AshMudaly/Capstone_HES_Project/5_Reported_data/thrust_and_hybrid_runs_filled.xlsx

Sheet: Setup
Setup: shared constants and run log
Yellow cells with blue text are typed in. Everything else calculates. Battery-only runs B1-B5 are RUN67-RUN71 (1200-1700 us profile). Hybrid runs H1-H5 are RUN75-RUN79 (1200-1700 us profile, Victron charge setpoint 16.70 V). Two further hybrid runs, RUN80 and RUN81, were kept outside this workbook.
Constants
COUNTS_PER_G (load cell) | 215.45 | Calibrated 30 Oct 2026. Masses pushing down gave -215.45 counts/g; the sketch flips the sign so prop thrust reads positive.
Averaging window at end of each step (ms) | 2500 | Last 2.5 s of each 5 s step. Used for every run, battery-only and hybrid.
Over-current stop in sketch (A) | 12 | MAX_CURRENT_A in the sketch.
Check: largest gap between logged thrust and net_counts / COUNTS_PER_G (g) | 0.01 | Battery-only data. About 0.05 g or less means the sketch used the same constant as B5 (thrust is logged to 0.1 g).
Run log
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
