AshMudaly/Capstone_HES_Project/3D Prints/Brick Base V5.stl

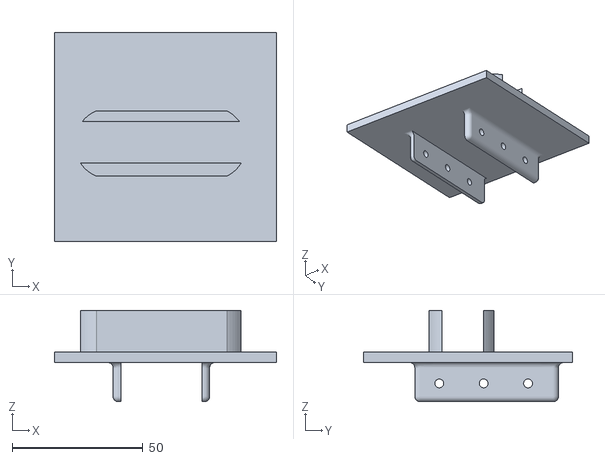
[picture p1: CAD file, 2026-10-30]
3D Prints/Brick Base V5.stl
85.0 x 80.0 x 35.0
