AshMudaly/Capstone_HES_Project/3D Prints/motor mount.stl

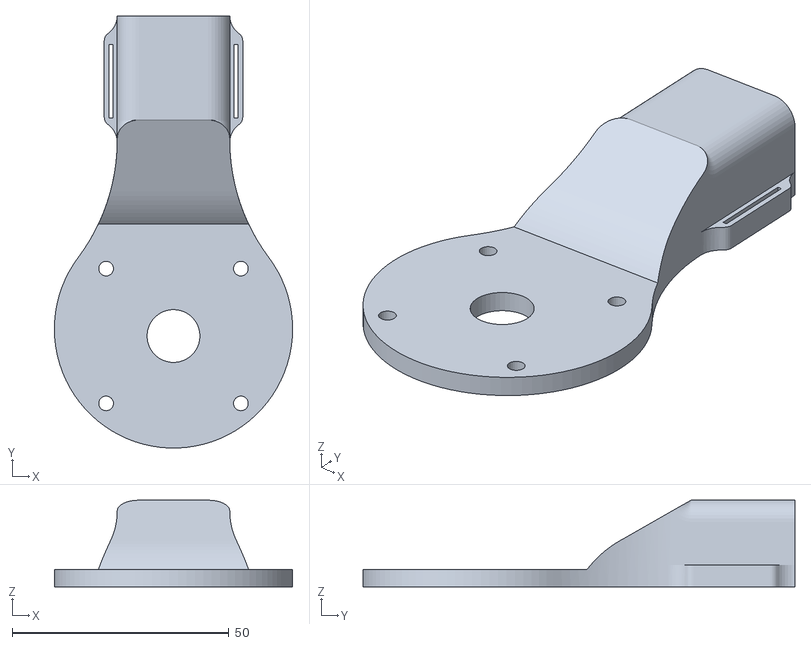
[picture p2: CAD file, 2026-10-30]
3D Prints/motor mount.stl
55.0 x 99.7 x 20.0
