AshMudaly/Capstone_HES_Project/3D Prints/Load_Cell_Stand.stl

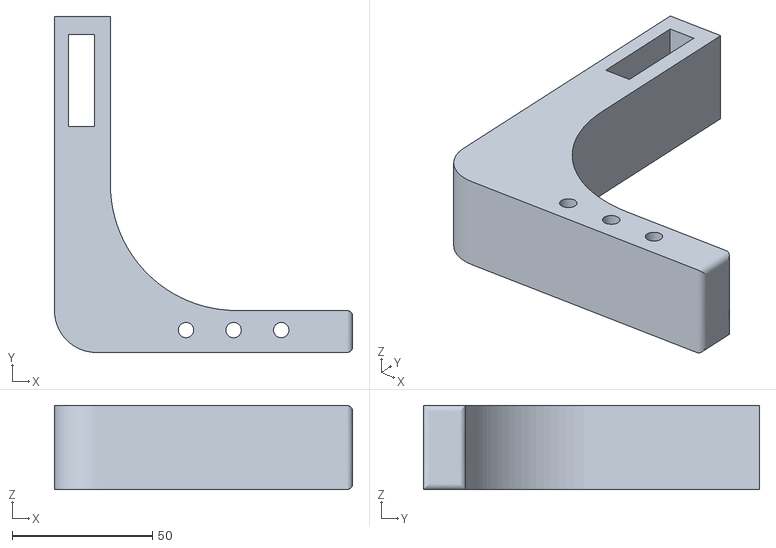
[picture p3: CAD file, 2026-10-30]
3D Prints/Load_Cell_Stand.stl
106.5 x 120.0 x 30.0
