AshMudaly/Capstone_HES_Project/(list of files, cad)

Other CAD files:
3D Prints/Brick Base V5.f3d
3D Prints/Load_Cell_Stand.f3d
3D Prints/motor mount.f3d
