AshMudaly/Capstone_HES_Project/(commit log)

2026-10-22 the HX711 is throwing some incorrect data, diagnosing the problem
    [main.cpp]
2026-10-23 debugging the load cell, appears to be showing very jittery movements with no substantial environmental factors
    [RUN00.CSV, RUN01.CSV, RUN02.CSV, RUN05.CSV, RUN10.CSV, RUN11.CSV, RUN12.CSV, RUN18.CSV]
2026-10-23 logging esc
2026-10-23 logged and ready
    [motor-bracket-large-16mm-19mm.stl]
2026-10-29 update new data again for methodlody
    [RUN01.CSV, RUN04.CSV, RUN07.CSV, RUN09.CSV, RUN12.CSV, RUN18.CSV, RUN23.CSV, RUN27.CSV]
2026-10-29 Add thesis run data: battery-only, hybrid, excluded, manifest
    - data/battery-only: B1-B5 (RUN40 inferred, RUN43, RUN45, RUN46, RUN48)
    - data/hybrid: run2 and run3
    - data/excluded: RUN42 (operator stop), RUN47 (idle only)
    - data/runs.csv: per-run manifest with start voltage, energies, SHA-256
    - data/README.md: layout, columns, provenance and open items
    Claude-Session: https://claude.ai/code/session_011XFaynhR4QPS9CZ6qD3grY
    [runs.csv]
2026-10-29 Data folder: confirm run numbers from SD footers, add RUN39 row
    - B1 is RUN40 (SD footer matches). Hybrid captures are RUN37 and RUN38.
    - runs.csv gains sd_footer_check; RUN39 listed as capture missing.
    - README provenance updated.
    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
    [runs.csv]
2026-10-29 doing the calibration of the load cell again to ensure accurate readings. Adjusted the calibration factor based on the new measurements and verified the output against known weights.
2026-10-30 load cell calibration testing, this is the file
2026-10-30 calibrated weight now
2026-10-30 Cleaning repository, Data folder has the reported runs, includes protoype phased runs
    [Brick Base V5.f3d, Brick Base V5.stl, Load_Cell_Stand.f3d, Load_Cell_Stand.stl, RUN01.CSV, RUN04.CSV, RUN07.CSV, RUN09.CSV]
2026-10-30 Changed structure to clearly indicate the prototpying work completed
    [RUN00.CSV, RUN01.CSV, RUN02.CSV, RUN04.CSV, RUN05.CSV, RUN07.CSV, RUN09.CSV, RUN10.CSV]
2026-10-30 Reorganised the github to be more legible and help with the report fluidity
    [RUN00.CSV, RUN01.CSV, RUN02.CSV, RUN04.CSV, RUN05.CSV, RUN07.CSV, RUN09.CSV, RUN10.CSV]
2026-10-31 cleanign up and adding readme
    [RUN37.CSV, RUN56.CSV, RUN63.CSV, RUN64.CSV, RUN65.CSV, RUN67.CSV, RUN68.CSV, RUN69.CSV]
2026-11-04 Correcting stuff and locations for appendix
    [B1_RUN67.csv, B2_RUN68.csv, B3_RUN69.csv, B4_RUN70.csv, B5_RUN71.csv, H1_RUN75.csv, H2_RUN76.csv, H3_RUN77.csv]
